senkolab/dsp_pid/bom.xlsx

QTY | REF | PACKAGE | VALUE | 15 | COLOR | COST | DESC | DIELECTRIC | MFG | MPN | PACKAGE | PRICE | SIZE | SOLIDMODEL | SOLIDWORKS_CONFIG | SOLIDWORKS_FILE | TOLERANCE | VALUE | VENDOR | VOLTAGE | VPN
1 | ~~ACC1,~~ |  |  |  |  |  | ~~PCB BOARD~~ |  |  |  |  | ~~10~~
4 | C1,C2,C35,C36, | R-0603 | 0.1U |  |  | 0.074 |  | X5R |  |  |  |  |  | CAP_NP_0603.g | SIZE_0603 | ChipCapacitor.SLDASM |  |  | DIGIKEY | 6.3V | 1276-1061-1-ND
6 | C3,C10,C12,C13,C43,C44, | R-0603 | 10N |  |  | 0.074 |  | X5R |  |  |  |  |  | CAP_NP_0603.g | SIZE_0603 | ChipCapacitor.SLDASM |  |  | DIGIKEY | 6.3V | 1276-1926-1-ND
11 | C4,C5,C6,C7,C8,C9,C11,C14,C15,C34,C49, | R-0603 | 1U |  |  | 0.074 |  | X5R |  |  |  |  |  | CAP_NP_0603.g | SIZE_0603 | ChipCapacitor.SLDASM |  |  | DIGIKEY | 6.3V | 1276-1019-1-ND
2 | C16,C17, | R-0603 | 10P |  |  | 0.074 |  | X5R |  |  |  |  |  | CAP_NP_0603.g | SIZE_0603 | ChipCapacitor.SLDASM |  |  | DIGIKEY | 6.3V | 399-8979-1-ND
4 | C18,C22,C26,C30, | R-0603 | 5.9N |  |  | 0.074 |  | X5R |  |  |  |  |  | CAP_NP_0603.g | SIZE_0603 | ChipCapacitor.SLDASM |  |  | DIGIKEY | 6.3V | 1276-2092-1-ND
4 | C19,C23,C27,C31, | R-0603 | 6.8N |  |  | 0.074 |  | X5R |  |  |  |  |  | CAP_NP_0603.g | SIZE_0603 | ChipCapacitor.SLDASM |  |  | DIGIKEY | 6.3V | 399-1089-1-ND
4 | C20,C24,C28,C32, | R-0603 | 2.5N |  |  | 0.074 |  | X5R |  |  |  |  |  | CAP_NP_0603.g | SIZE_0603 | ChipCapacitor.SLDASM |  |  | DIGIKEY | 6.3V | 490-3282-1-ND
4 | C21,C25,C29,C33, | R-0603 | 16.5N |  |  | 0.074 |  | X5R |  |  |  |  |  | CAP_NP_0603.g | SIZE_0603 | ChipCapacitor.SLDASM |  |  | DIGIKEY | 6.3V | 478-10349-1-ND
6 | C37,C38,C41,C42,C45,C46, | CAP-SIZEA-1206 | 10U |  |  | 0.8 |  | TANT | AVX | TAJA-SERIES |  |  |  | CAP_TANT_SIZE_A.g | SIZE_A | TantalumCap.SLDASM |  |  | DIGIKEY | 6.3V | 478-8237-1-ND
2 | C39,C40, | CAP-SIZEA-1206 | 4.7U |  |  | 0.8 |  | TANT | AVX | TAJA-SERIES |  |  |  | CAP_TANT_SIZE_A.g | SIZE_A | TantalumCap.SLDASM |  |  | DIGIKEY | 6.3V | 478-11461-1-ND
2 | C47,C48, | R-0603 | 100P |  |  | 0.074 |  | X5R |  |  |  |  |  | CAP_NP_0603.g | SIZE_0603 | ChipCapacitor.SLDASM |  |  | DIGIKEY | 6.3V | 399-8980-1-ND
4 | D1,D2,D3,D4, | 0402-DFN | TVS_SESD0402 |  |  |  |  |  | LITTLEFUSE | SESD0402X1BN-0010-098 |  | 0.68 |  |  |  |  |  |  | DIGIKEY |  | SESD0402X1BN-0010-098CT-ND
3 | D5,D6,D7, | DO-220AA | SCHOTTKY_SS2P4 |  |  | 0.39 |  |  | VISHAY | SS2P4-E3 |  |  |  |  |  |  |  |  | DIGIKEY |  | ~~SS2P4-E3/A8AICT-ND~~ | SS2P6-M3/84AGICT-ND
1 | J1, | 2X07X0.100_HDR | HDR_2X07X100 |  |  |  |  |  | 3M | 961214-6404-AR |  | 1.66 |  |  |  |  |  |  | DIGIKEY |  | 3M9466-14-ND
4 | J2,J3,J4,J5, | CONN_SMB_GND | CONN_SMA_VERT |  |  |  |  |  | AMP | 5-1814832-1 |  | 1.94 |  |  |  |  |  |  | DIGIKEY |  | A97594-ND
1 | J6, | CUI_RCJ-02X | CONN_RCA-BLACK-BLK |  | BLK |  |  |  | CUI INC | RCJ-021 |  | 0.88 |  |  |  |  |  |  | DIGIKEY |  | CP-1406-ND
1 | J7, | CUI_RCJ-02X | CONN_RCA-RED-BLK |  | RED |  |  |  | CUI INC | RCJ-022 |  | 0.88 |  |  |  |  |  |  | DIGIKEY |  | CP-1407-ND
1 | J8, | CUI_RCJ-02X | CONN_RCA-BLU-BLK |  | BLU |  |  |  | CUI INC | RCJ-025 |  | 0.88 |  |  |  |  |  |  | DIGIKEY |  | CP-1410-ND
3 | J9,J10,J11, | OST_SCREWTERM_2.54MM_2POS | CONN_SCREWTERM_2.54MM_2POS |  |  |  |  |  | ON SHORE TECH | OSTVN02A150 |  | 1.24 |  |  |  |  |  |  | DIGIKEY |  | ED10561-ND
1 | L1, | L-1206 | 4.7U |  |  |  |  |  |  |  |  |  | 1206 |  |  |  |  |  | DIGIKEY |  | 490-10585-1-ND
1 | L2, | L-1206 | 2.2U |  |  |  |  |  |  |  |  |  | 1206 |  |  |  |  |  | DIGIKEY |  | 587-1623-1-ND
13 | R1,R4,R5,R6,R7,R8,R10,R15,R16,R17,R19,R36,R46, | R-0603 | 33 |  |  |  |  |  |  |  | 603 | 0.059 |  | res0603.g | SIZE_0603 | ChipResistor.SLDASM | 1% |  | DIGIKEY |  | 311-33GRCT-ND
12 | R2,R3,R9,R11,R12,R13,R14,R38,R43,R44,R45,R47, | R-0603 | 10K |  |  |  |  |  |  |  | 603 | 0.059 |  | res0603.g | SIZE_0603 | ChipResistor.SLDASM | 1% |  | DIGIKEY |  | 311-10KGRCT-ND
1 | R18, | R-0603 | 10M |  |  |  |  |  |  |  | 603 | 0.059 |  | res0603.g | SIZE_0603 | ChipResistor.SLDASM | 1% |  | DIGIKEY |  | 311-10MGRCT-ND
16 | R20,R21,R22,R23,R24,R25,R26,R27,R28,R29,R30,R31,R32,R33,R34,R35, | R-0603 | 500 |  |  |  |  |  |  |  |  | 0.059 |  | res0603.g | SIZE_0603 | ChipResistor.SLDASM |  |  | DIGIKEY |  | 311-499HRCT-ND
1 | R37, | R-1206 | 0-OHM |  |  |  |  |  |  |  | 1206 | 0.03 |  | res1206.g | SIZE_01206 | ChipResistor.SLDASM | 1% |  | DIGIKEY |  | YAG3375CT-ND
1 | R39, | R-0603 | 540K |  |  |  |  |  |  |  | 603 | 0.059 |  | res0603.g | SIZE_0603 | ChipResistor.SLDASM | 1% |  | DIGIKEY
1 | R40, | R-0603 | 120K |  |  |  |  |  |  |  | 603 | 0.059 |  | res0603.g | SIZE_0603 | ChipResistor.SLDASM | 1% |  | DIGIKEY |  | 311-120KGRCT-ND
2 | R41,R42, | R-0603 | 100K |  |  |  |  |  |  |  | 603 | 0.059 |  | res0603.g | SIZE_0603 | ChipResistor.SLDASM | 1% |  | DIGIKEY |  | 311-100KHRCT-ND
2 | U1,U2, | TSSOP-14 | AMP_OPA1679 |  |  |  |  |  | TEXAS INST | OPA1679IPWR |  |  |  |  |  |  |  |  | DIGIKEY
1 | U3, | TSSOP-20 | CODEC_AK4556 |  |  |  |  |  | AKM SEMI | AK4556VT |  | 5.45 |  |  |  |  |  |  | DIGIKEY |  | 974-1021-1-ND
1 | U4, | LFCSP-64 | DSP_BF592 |  |  |  |  |  | ANALOG DEVICES | ADSP-BF592KCPZ-2 |  | 6.25 |  |  | LFCSP-64 | LFCSP.SLDASM |  |  | DIGIKEY |  | ADSP-BF592KCPZ-2-ND
1 | U5, | SOIC-8 | FLASH_SST25VF080B |  |  |  |  |  | MICROCHIP | SST25VF080B-50-4C-S2AF-T |  | 1.83 |  |  |  |  |  |  | DIGIKEY |  | SST25VF080B-50-4C-S2AF-T-ND
1 | U6, | LANTRONIX-XPORT | ETHERNET_LANTRONIX_XPORT |  |  |  |  |  | LANTRONIX | XP1001000-05R |  | 45.88 |  |  |  |  |  |  | DIGIKEY |  | 1829-1005-ND
1 | U7, | WDFN-12 | REG_PAM2306D |  |  |  |  |  | DIODES INC | PAM2306DYPAA |  | 0.73 |  |  |  |  |  |  | DIGIKEY |  | PAM2306DYPAADICT-ND
1 | U8, | DFN-14_SPLITPAD | REG_LT3032 |  |  |  |  |  | LINEAR TECH | LT3032EDE-5 |  | 4.79 |  |  |  |  |  |  | DIGIKEY |  | LT3032EDE-5#PBF-ND
1 | U9, | SOT23-3 | SUPRVISOR-APX803S |  |  |  |  |  | DIODES INC | APX803S-31SA-7 |  | 0.53
1 | X1, | XTAL_ABRACON_ALBS | XTAL_ABLS_SERIES |  |  |  |  |  | ABRACON | ABLS-24.000MHZ-L4QF-T |  | 0.76 |  |  |  |  |  | 12 MHz | DIGIKEY |  | 535-9918-1-ND
