senkolab/dsp_pid/PCBAssembly.SLDASM

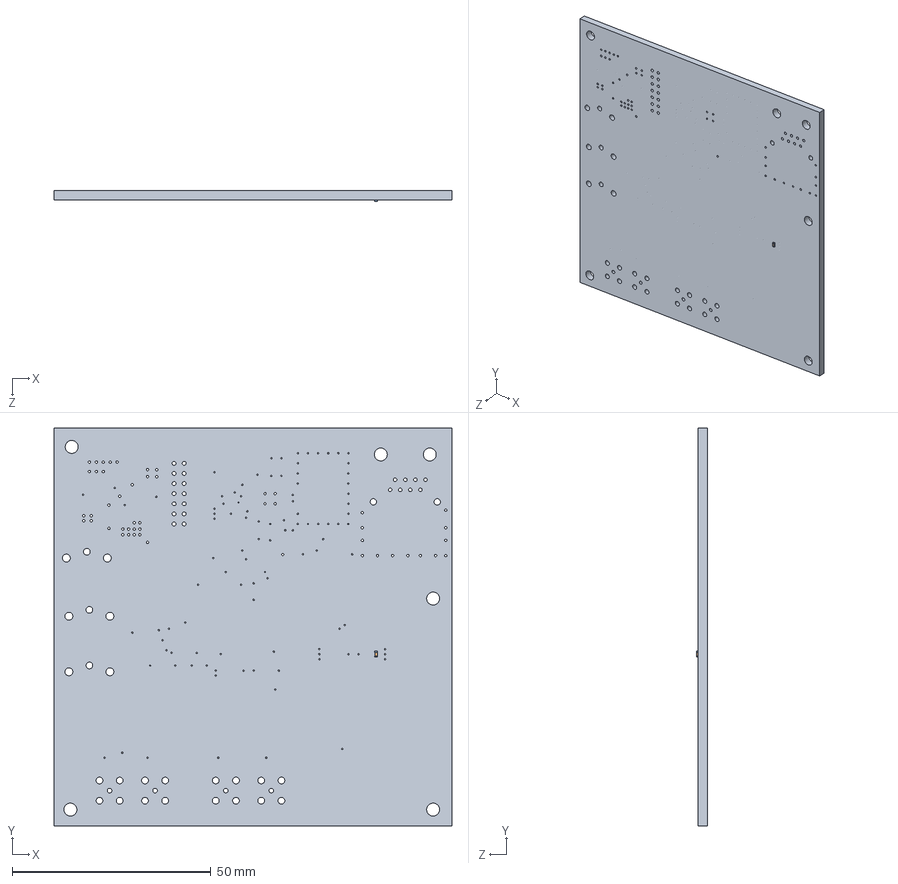
[picture p1: CAD file, 2018-01-19]
PCBAssembly.SLDASM
100.0 x 100.0 x 2.80 mm
PCB
ChipCapacitor_Body x 10
ChipCapacitor_Terminal x 20
