senkolab/dsp_pid/DSP_PID.pdf

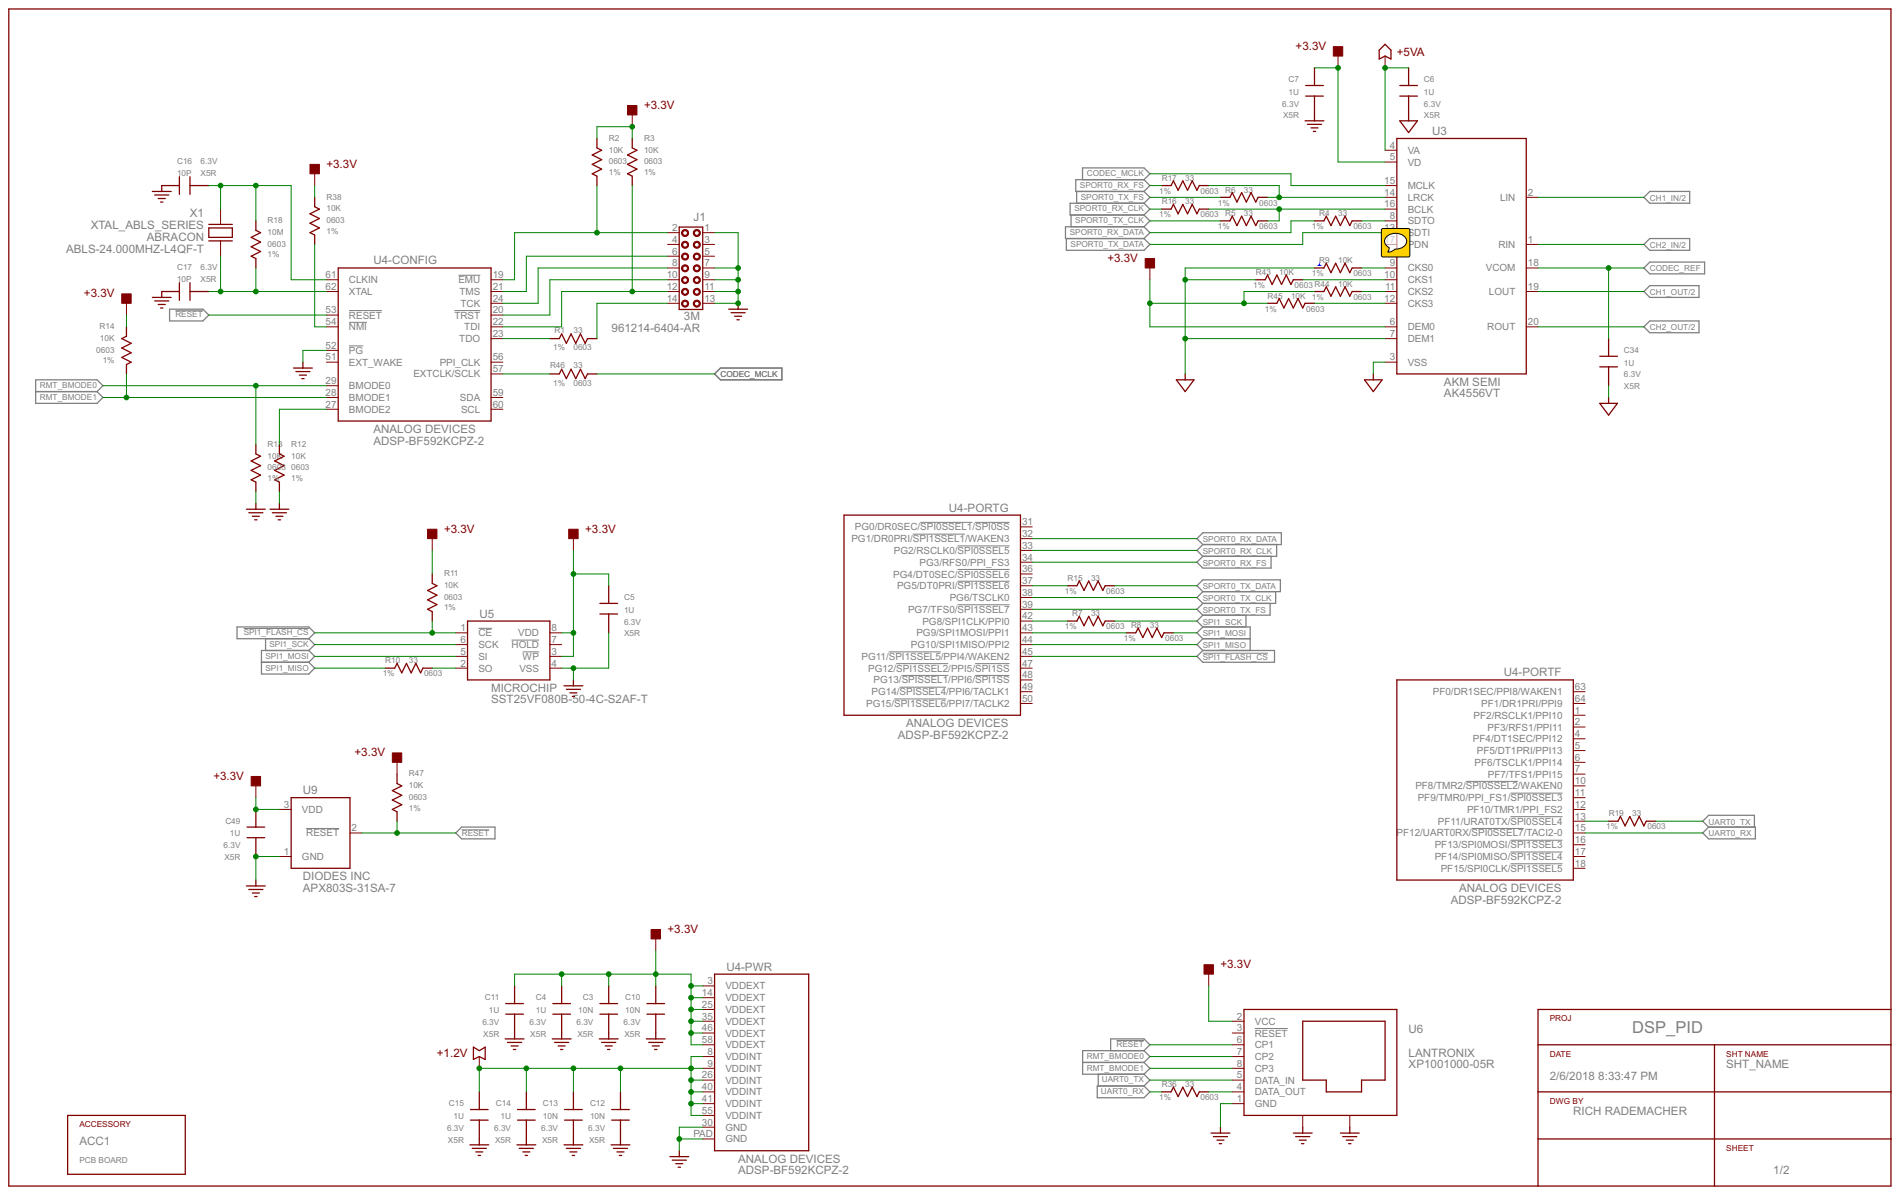
[picture p7: page 1]

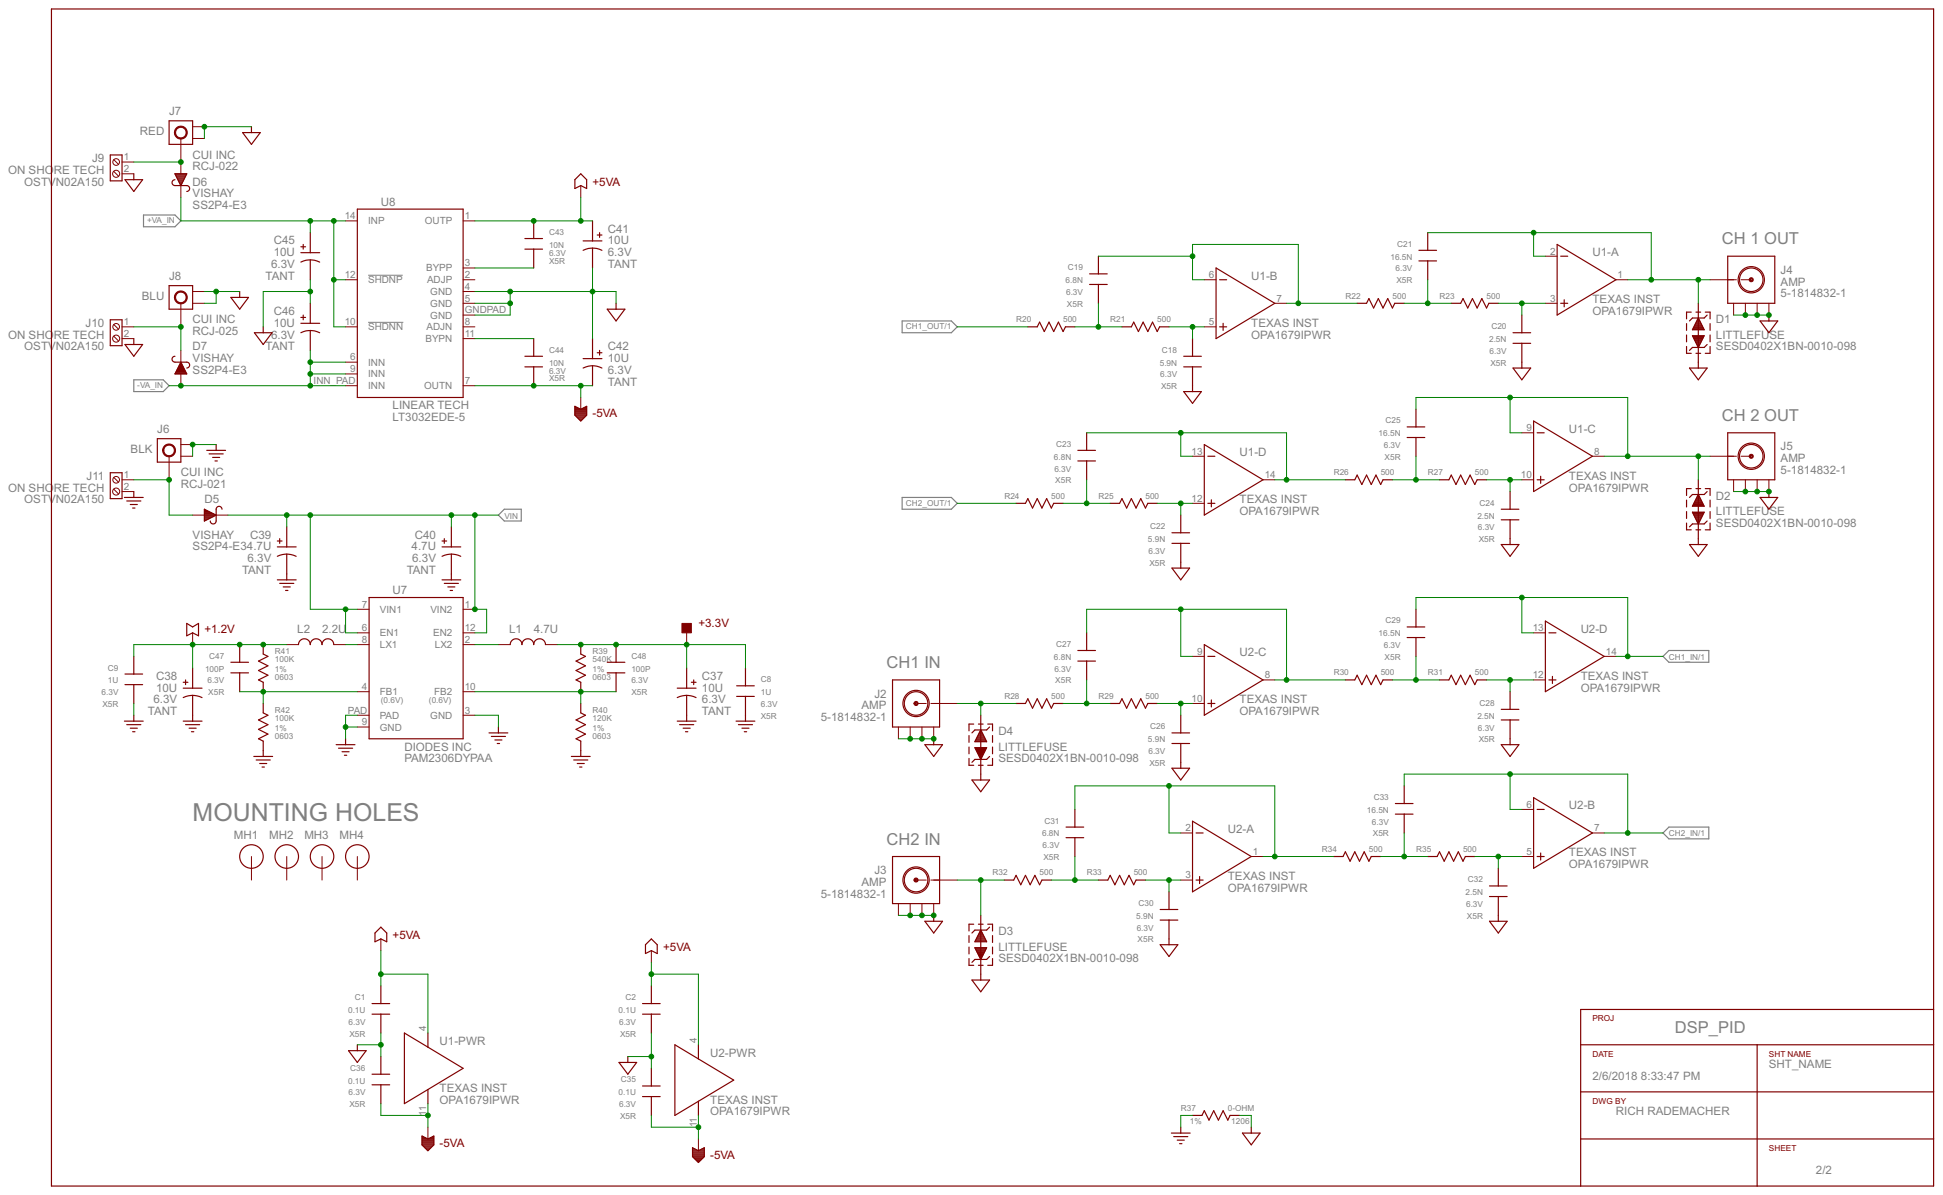
[picture p8: page 2]

DATE 2/6/2018 8:33:47 PM | SHT NAME SHT_NAME

RICH RADEMACHER | SHEET DWG BY
