senkolab/dsp_pid/src/blackfin/include/processor/power.h

#ifndef _POWER_H_
#define _POWER_H_
////////////////////////////////////////////////////////////////////////////////
// 
// power.h - header for  blackfin power and clocking
//
// Written by Rich Rademacher  UWaterloo/IQC
// March 2018
//
////////////////////////////////////////////////////////////////////////////////

#include <types.h>
#include <processor\power.h>
#include <pid_board.h>

//
// init_power() - set up power registers
//
extern void init_power(void);

#endif /* _POWER_H_ */
