senkolab/dsp_pid/(commit log)

2018-01-19 Import from SVN
    [BF592_PINDEFS.csv, BF592_PINDEFS.xlsx, DSP_PID.brd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]
2018-02-06 ADDED MCLK TO CODEC
    [DSP_PID.brd, DSP_PID.sch]
2018-02-06 UPDATED GERBERS
    [DSP_PID.bmask.gbr, DSP_PID.l15.gbr, DSP_PID.ly1.gbr, DSP_PID.ly16.gbr, DSP_PID.ly2.gbr, DSP_PID.tmask.gbr, DSP_PID.topsilk.gbr, DSP_PID.tpaste.gbr]
2018-02-07 ADDED POWER GOOD INDICATION
    [DSP_PID.brd, DSP_PID.sch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]
2018-02-12 upload to pcb house
2018-02-28 Manufacturing files for Rev A
    [bom.xlsx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]
2018-03-15 Removed errorneous polygon from dsp_pid.brd that shorted VIN to GND. Updated bom.xlsx
    [DSP_PID.brd, bom.xlsx]
2018-03-15 Changes to SMA_VERT center drill, added keepout to CONN_RCA, reduced drill diam to OST_SCREWTERM
2018-03-22 added sketch DSP PID Controller Board Bringup.docx
2018-03-22 added pid.h
2018-03-22 added pid.asm
2018-03-22 test pid project
2018-03-25 added uart driver
2018-03-25 added power control driver templates
2018-03-25 added uart_isr.asm
2018-03-27 updates to uart.c
2018-03-29 successful test of base uart capability
2018-06-26 Rev B PCB Finished
2018-09-14 Correct register settings for test_sport.c
    [test_sport.c]
2018-09-14 incremental updates to files associated with power control
2018-10-05 Preliminary working sport_test.dxe with glitches
    [power.c, power.h, test_sport.c]
2018-10-05 correct test_sport.c for AD4553 at 46ksps
    [test_sport.c]
2018-10-13 moved codec reset to a GPIO
    [test_sport.c]
2019-01-20 Source code test prior to board spin
